Miren16/Locker-Project/Documentations/Locker Project Presentation.pdf

‘-

1

# Locker Project

Team Members:

Tijmen Van Der Beek

Miren Patel

Siquan Wang

Xiaoang Zhang

Dazhou Liu

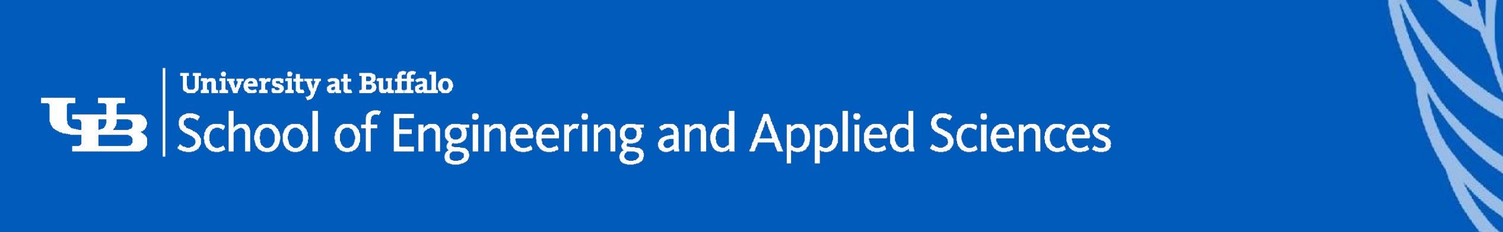
[picture p7: figure]

‘-

2

# Introduction

- The Depew High School locker project focuses on customized lockers for individuals with physical disability. According to the needs of the client, each lock has to be designed specifically for each user to solve their problem with accessing the locker independently.
- The purpose of the Alden High School Locker is to design an automated and easily operated locker for Alden High School. The locker we designed is a prototype and the idea is that they can run multiple of them off of one battery.

# Alden Flowchart

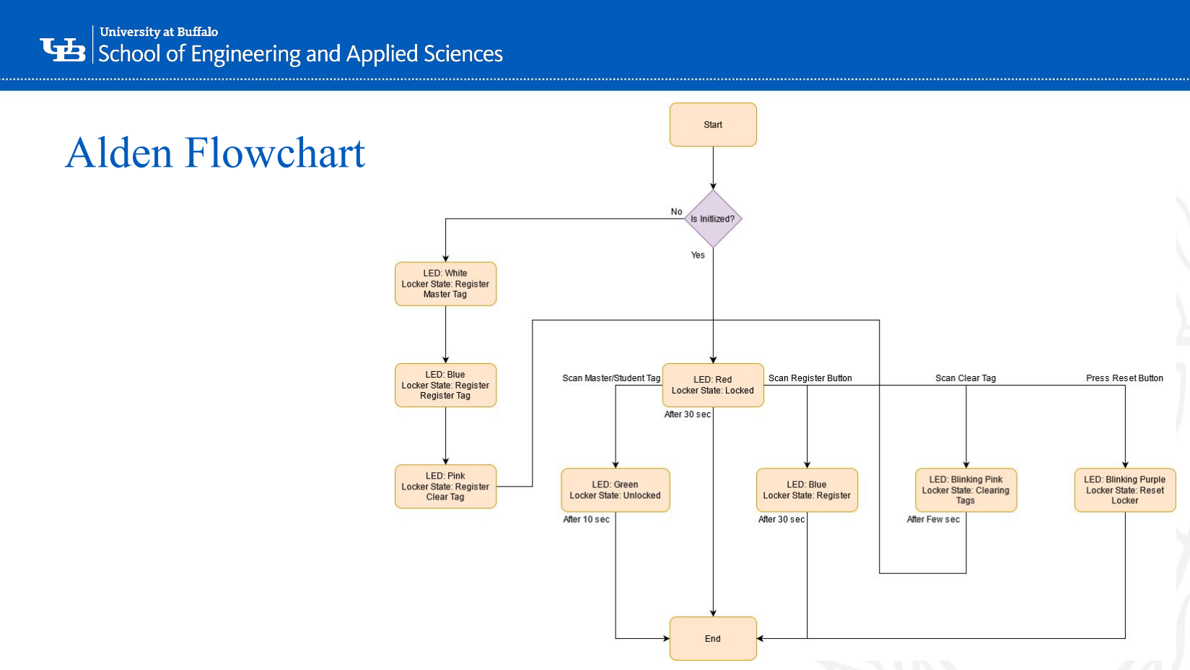
[picture p8: page 3]

‘-

3

# Depew Flowchart

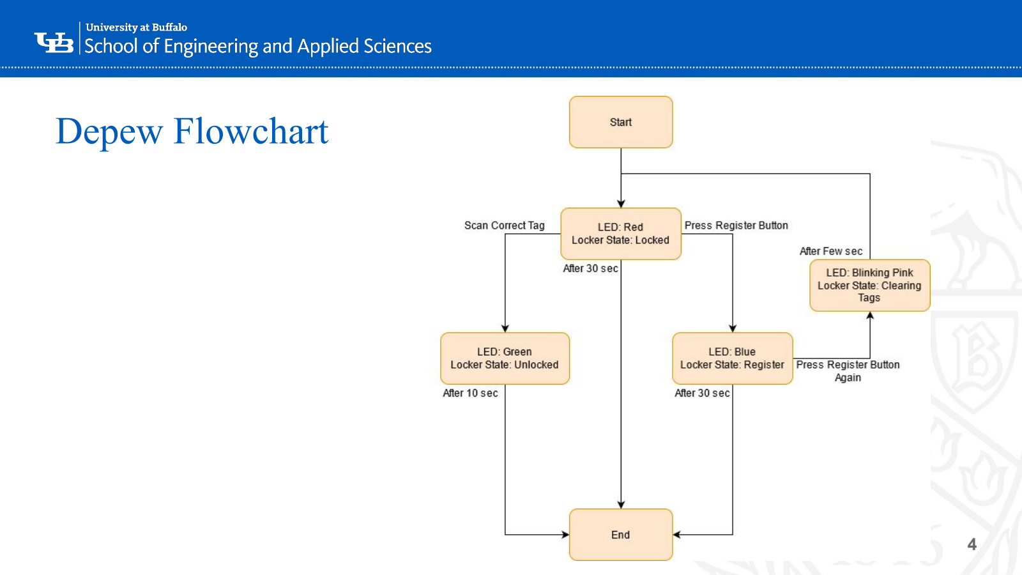
[picture p9: page 4]

‘-

4

# Schematic

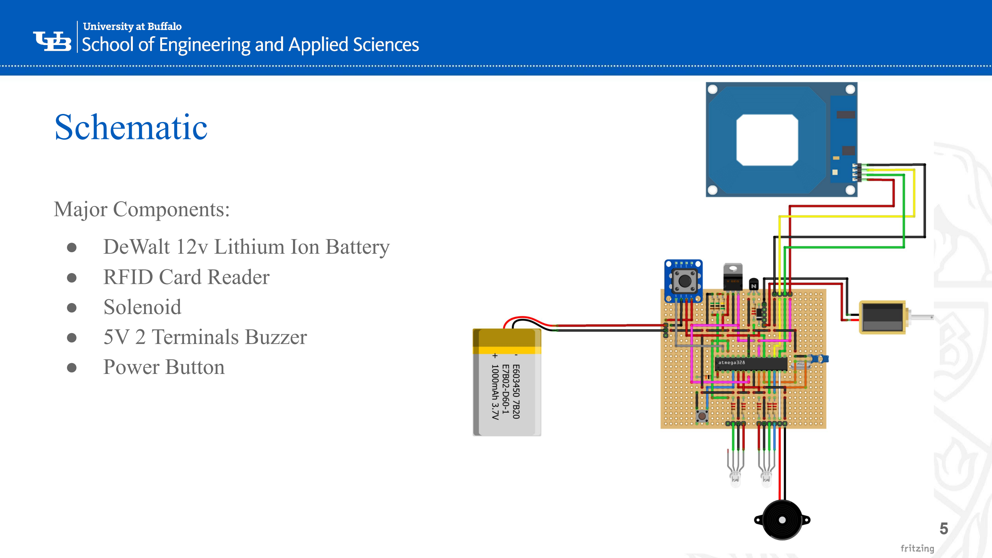
[picture p10: page 5]

‘-

5

Major Components:

- DeWalt 12v Lithium Ion Battery
- RFID Card Reader
- Solenoid
- 5V 2 Terminals Buzzer
- Power Button

# Case Outside

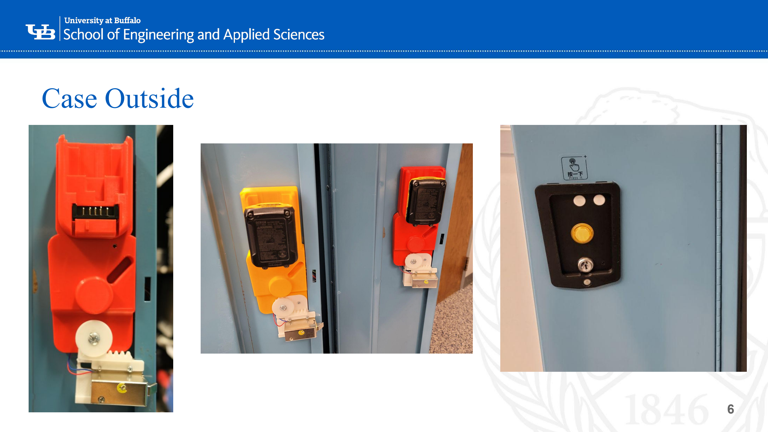
[picture p11: page 6]

‘-

6

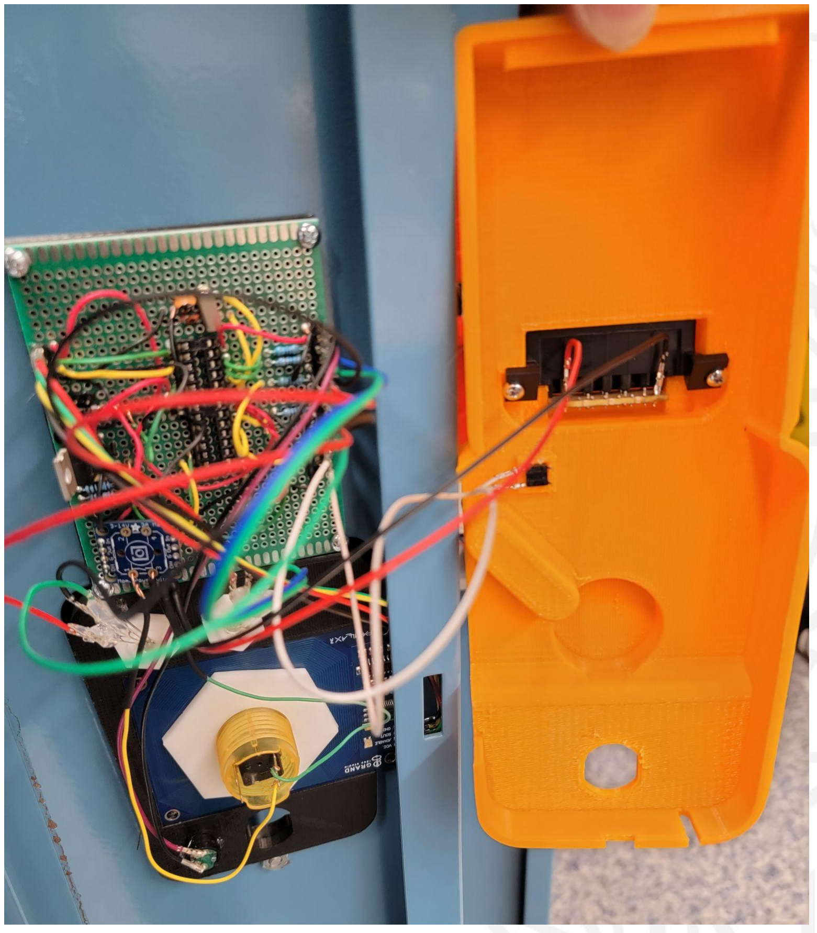
[picture p12: figure]

7

# Case Inside

This is the inside of the
case which shows our
circuit along with the
additional components.

# Mechanical Override

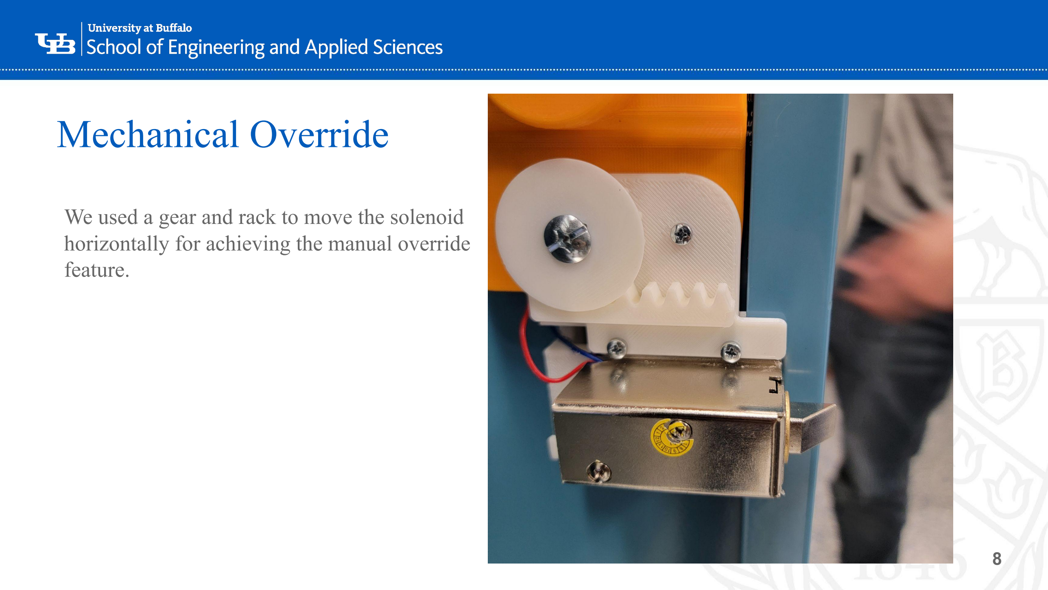
[picture p13: page 8]

‘-

8

We used a gear and rack to move the solenoid horizontally for achieving the manual override feature.

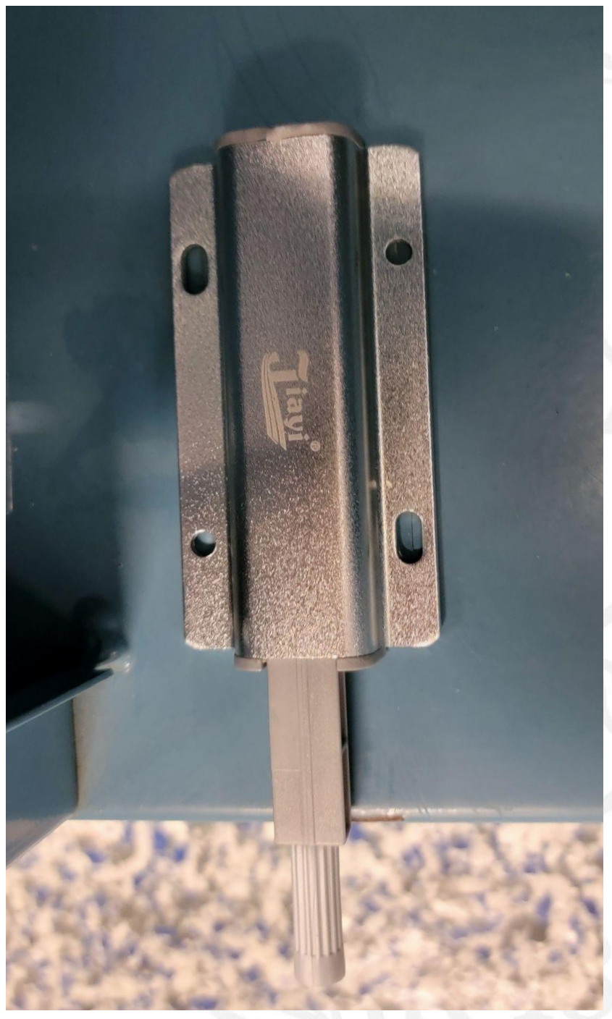
[picture p14: figure]

9

# Depew Locker Spring

We installed a magnetic push latch for each locker. This latch push opens the door automatically once unlock.

‘-

10

## Possible Upgrades

- Improve Mechanical Override (New method / Better build quality)
- Manufactured Circuit Board
- Improvement on some parts of the case
- Design a case that works with the Alden Latch
- Design it with a bigger battery like 20v Dewalt
- Disable reset button to Students (Alden Locker Bank)
- Put multiple lockers in parallel with one battery
- Improve on issues that come up during testing
- Improve energy efficiency

11

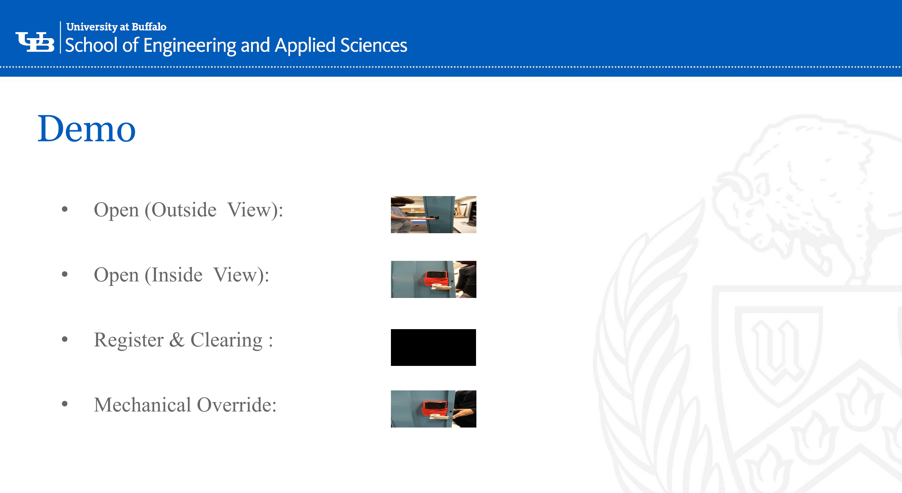
[picture p15: figure]
Demo; • Open (Outside View):; • Open (Inside View):; • Register & Clearing :; • Mechanical Override:
