Miren16/Locker-Project/3D Printed Files/Locker STL Files/Case_Back.stl

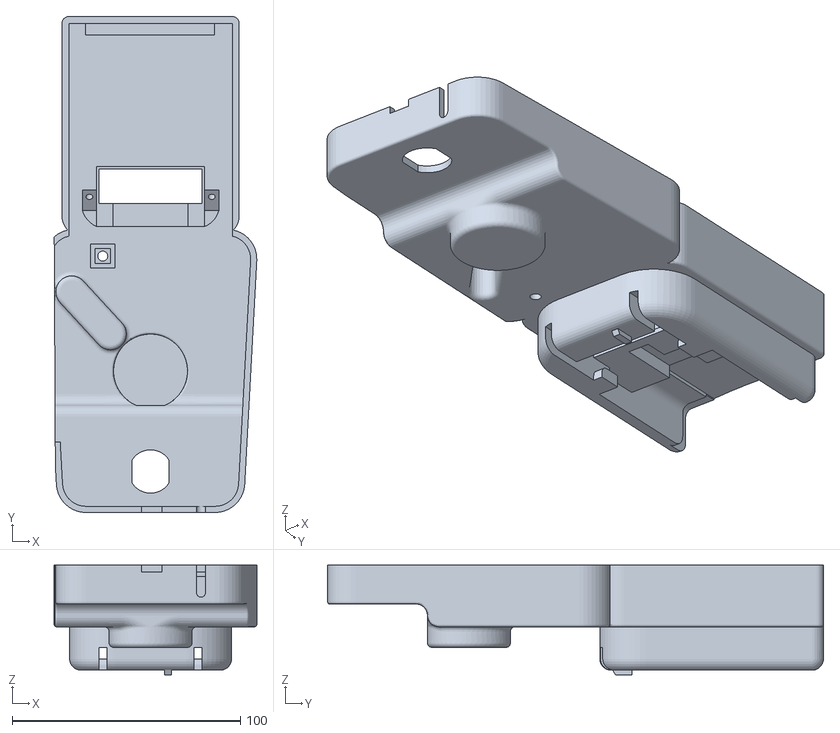
[picture p16: CAD file, 2021-05-18]
3D Printed Files/Locker STL Files/Case_Back.stl
88.7 x 217.3 x 48.0
