Miren16/Locker-Project/3D Printed Files/Locker STL Files/SolenoidGear.stl

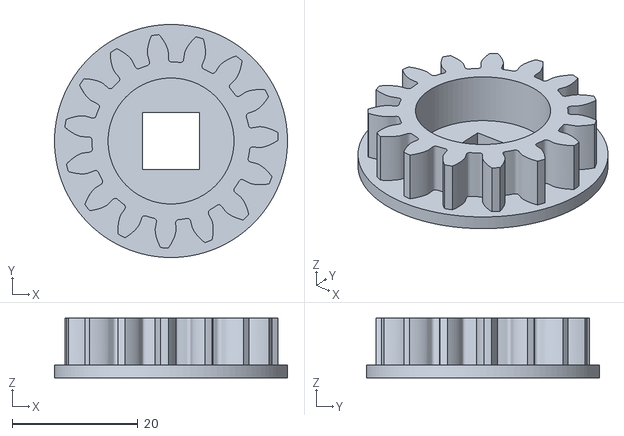
[picture p17: CAD file, 2021-05-18]
3D Printed Files/Locker STL Files/SolenoidGear.stl
37.0 x 37.0 x 9.47
