Miren16/Locker-Project/3D Printed Files/Locker STL Files/SolenoidRack.stl

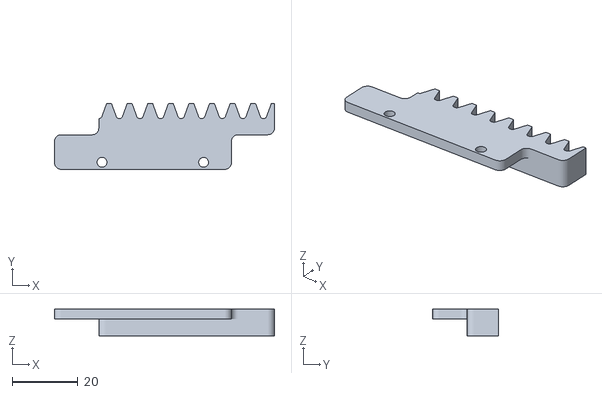
[picture p18: CAD file, 2021-05-18]
3D Printed Files/Locker STL Files/SolenoidRack.stl
67.1 x 20.0 x 8.17
