Miren16/Locker-Project/3D Printed Files/Locker STL Files/LedNut.stl

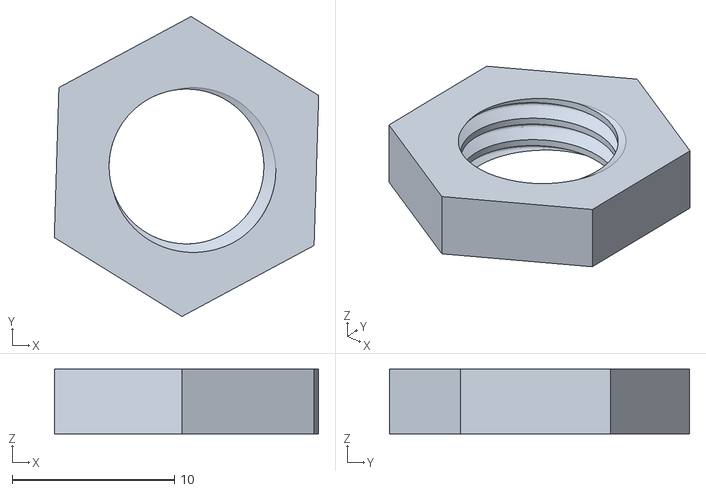
[picture p19: CAD file, 2021-05-18]
3D Printed Files/Locker STL Files/LedNut.stl
16.3 x 18.5 x 4.00
