Miren16/Locker-Project/3D Printed Files/Locker STL Files/LedCap.stl

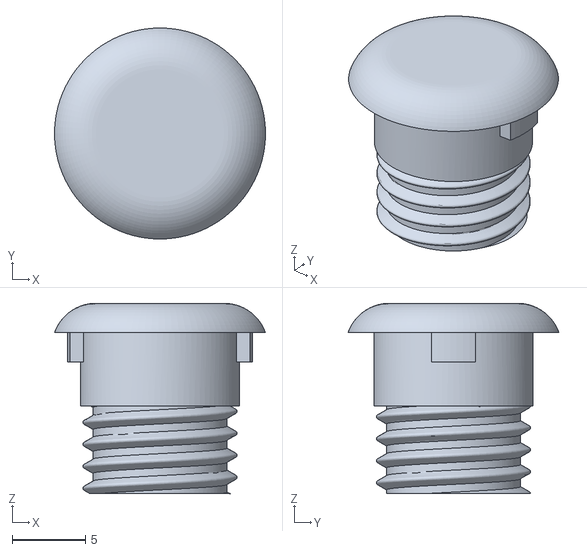
[picture p20: CAD file, 2021-05-18]
3D Printed Files/Locker STL Files/LedCap.stl
14.4 x 14.4 x 13.0
