Miren16/Locker-Project/3D Printed Files/Locker STL Files/Case_Front.stl

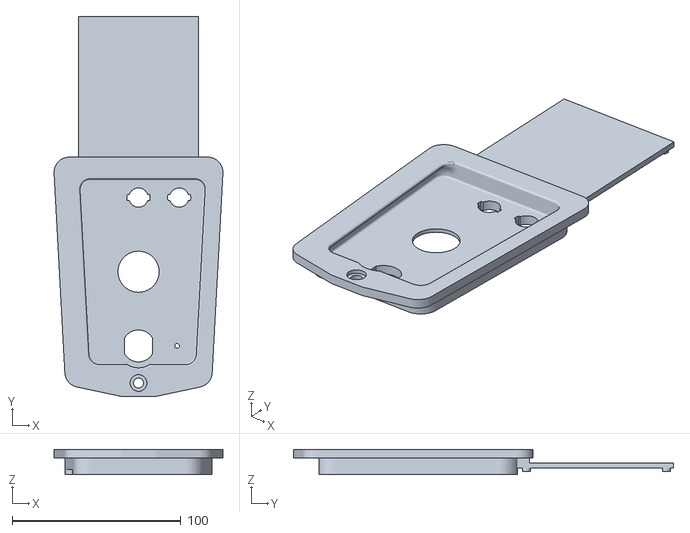
[picture p21: CAD file, 2021-05-18]
3D Printed Files/Locker STL Files/Case_Front.stl
100.2 x 225.4 x 15.0
