Miren16/Locker-Project/3D Printed Files/Locker STL Files/ButtonNut.stl

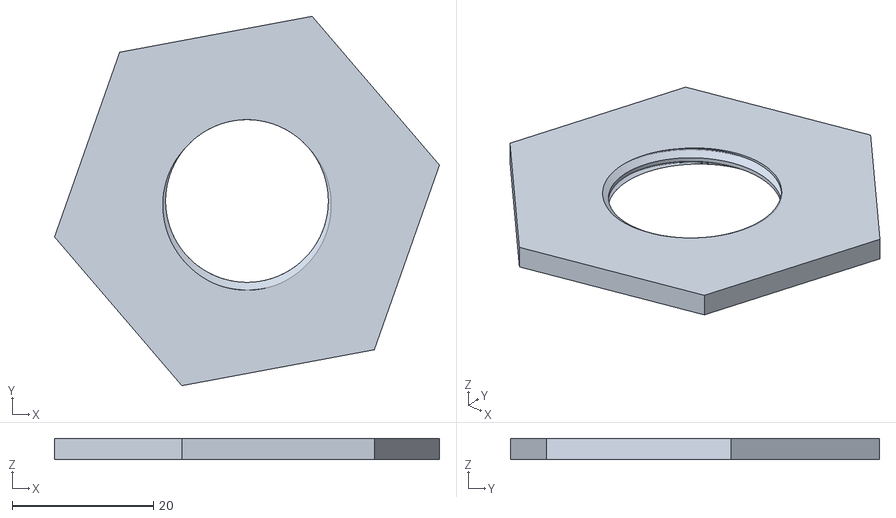
[picture p22: CAD file, 2021-05-18]
3D Printed Files/Locker STL Files/ButtonNut.stl
54.5 x 52.3 x 3.00
