Miren16/Locker-Project/3D Printed Files/Locker STL Files/SolenoidMount.stl

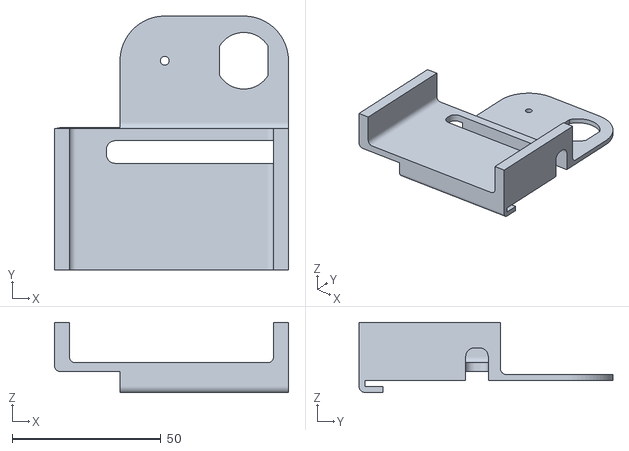
[picture p23: CAD file, 2021-05-18]
3D Printed Files/Locker STL Files/SolenoidMount.stl
78.5 x 85.2 x 23.5
