Miren16/Locker-Project/3D Printed Files/Locker STL Files/SolenoidRack(L).stl

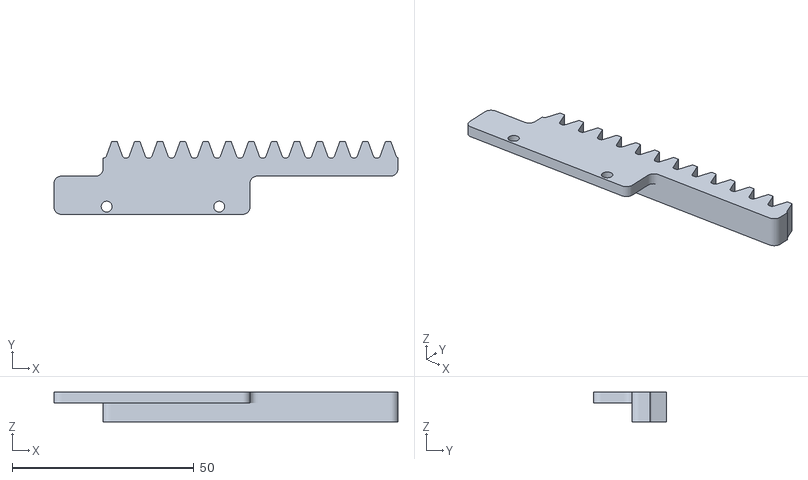
[picture p24: CAD file, 2021-05-18]
3D Printed Files/Locker STL Files/SolenoidRack(L).stl
94.8 x 20.0 x 8.17
