Miren16/Locker-Project/(list of files, cad)

Other CAD files:
3D Printed Files/Locker Fusion 360 Files/Rack and Gear (For creating a rack and gear).f3d
